shadow2418889/digital-typewriter/PCBs/3d models/dt-keyboard.step

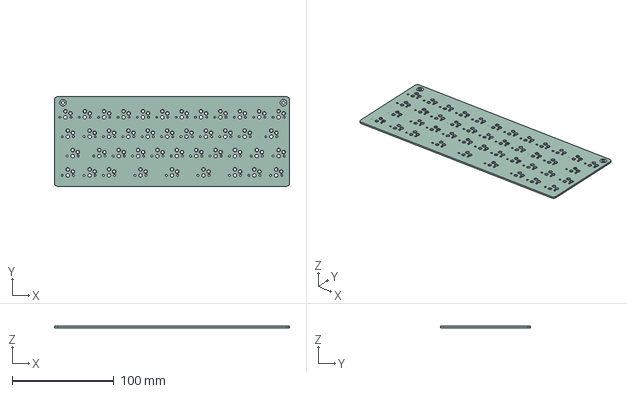
[picture p1: CAD file, 2025-12-10]
PCBs/3d models/dt-keyboard.step
231.0 x 88.1 x 1.59 mm
dt-keyboard_pad
dt-keyboard_PCB
