shadow2418889/digital-typewriter/journal assets/Part Studio 1(1).png

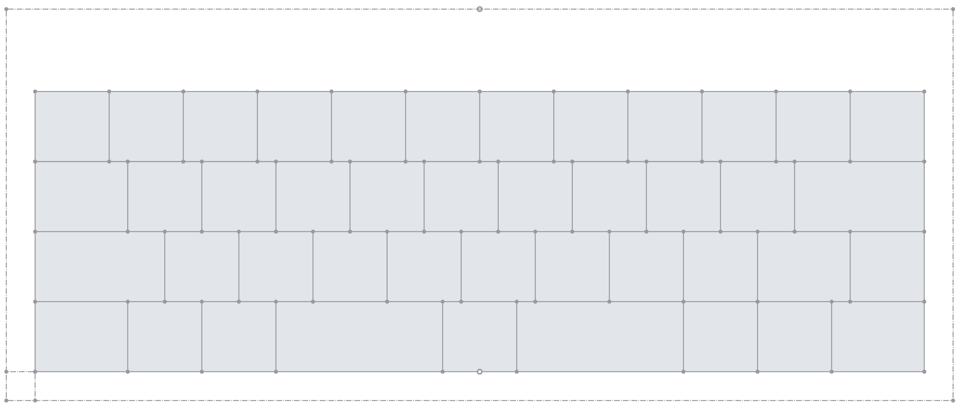
journal assets/Part Studio 1(1).png
