shadow2418889/digital-typewriter/PCBs/keyboard/dt-keyboard.kicad_pcb

## KiCad design PCBs/keyboard/dt-keyboard.kicad_pcb (2025-12-10)

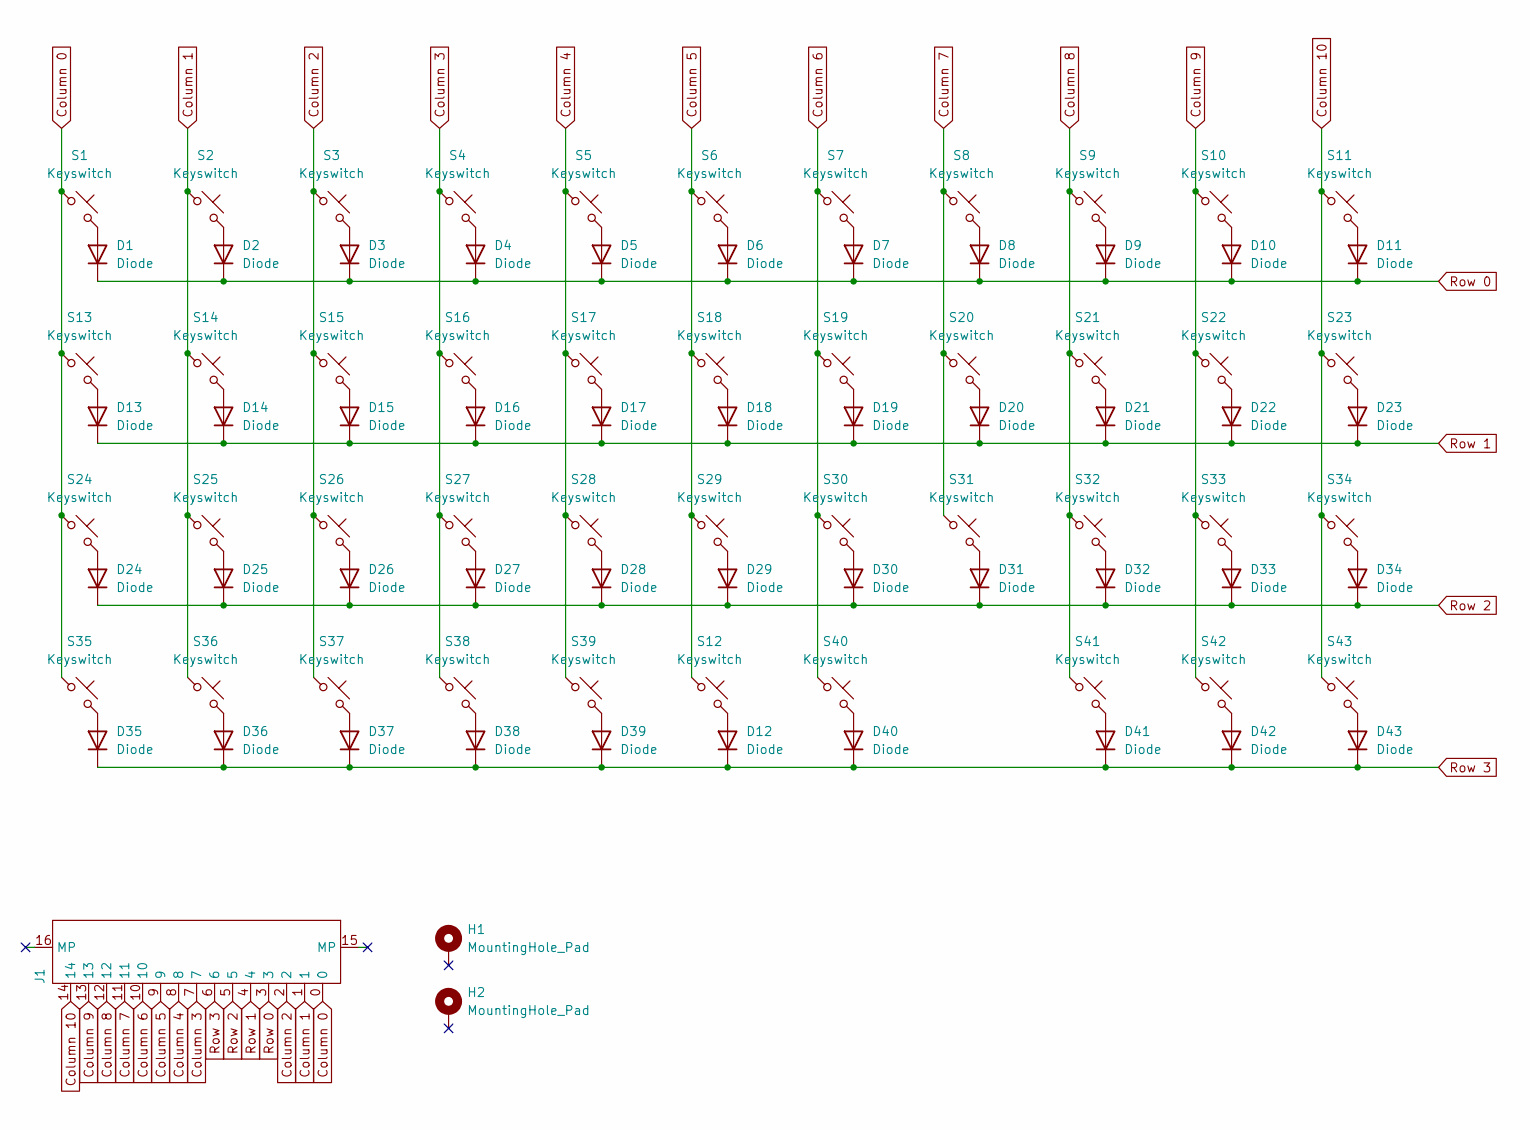
[picture p25: schematic dt-keyboard.kicad_sch]

Parts:
D1, D2, D3, D4, D5, D6, D7, D8, D9, D10, D11, D12, D13, D14, D15, D16, D17, D18, D19, D20, D21, D22, D23, D24, D25, D26, D27, D28, D29, D30, D31, D32, D33, D34, D35, D36, D37, D38, D39, D40, D41, D42, D43: Diode; Diode_SOD-123
H1, H2: MountingHole_Pad; MountingHole_3.2mm_M3_Pad_TopBottom
J1: FPC_15
S1, S2, S3, S4, S5, S6, S7, S8, S9, S10, S11, S12, S14, S15, S16, S17, S18, S19, S20, S21, S22, S25, S26, S27, S28, S29, S30, S31, S32, S34, S36, S37, S39, S41, S42: Keyswitch; MX Hotswap_Choc_V1_Plated_1.00u
S13, S33, S35, S43: Keyswitch; MX Hotswap_Choc_V1_Plated_1.25u
S23, S24: Keyswitch; MX Hotswap_Choc_V1_Plated_1.75u
S38, S40: Keyswitch; MX Hotswap_Choc_V1_Plated_2.25u

Connections:
Column 0: J1.0, S1.1, S13.1, S24.1, S35.1
Column 1: J1.1, S2.1, S14.1, S25.1, S36.1
Column 2: J1.2, S3.1, S15.1, S26.1, S37.1
Column 3: J1.7, S4.1, S16.1, S27.1, S38.1
Column 4: J1.8, S5.1, S17.1, S28.1, S39.1
Column 5: J1.9, S6.1, S12.1, S18.1, S29.1
Column 6: J1.10, S7.1, S19.1, S30.1, S40.1
Column 7: J1.11, S8.1, S20.1, S31.1
Column 8: J1.12, S9.1, S21.1, S32.1, S41.1
Column 9: J1.13, S10.1, S22.1, S33.1, S42.1
Column 10: J1.14, S11.1, S23.1, S34.1, S43.1
unnamed: D1.2 (A), S1.2
unnamed: D2.2 (A), S2.2
unnamed: D3.2 (A), S3.2
unnamed: D4.2 (A), S4.2
unnamed: D5.2 (A), S5.2
unnamed: D6.2 (A), S6.2
unnamed: D7.2 (A), S7.2
unnamed: D8.2 (A), S8.2
unnamed: D9.2 (A), S9.2
unnamed: D10.2 (A), S10.2
unnamed: D11.2 (A), S11.2
unnamed: D12.2 (A), S12.2
unnamed: D13.2 (A), S13.2
unnamed: D14.2 (A), S14.2
unnamed: D15.2 (A), S15.2
unnamed: D16.2 (A), S16.2
unnamed: D17.2 (A), S17.2
unnamed: D18.2 (A), S18.2
unnamed: D19.2 (A), S19.2
unnamed: D20.2 (A), S20.2
unnamed: D21.2 (A), S21.2
unnamed: D22.2 (A), S22.2
unnamed: D23.2 (A), S23.2
unnamed: D24.2 (A), S24.2
unnamed: D25.2 (A), S25.2
unnamed: D26.2 (A), S26.2
unnamed: D27.2 (A), S27.2
unnamed: D28.2 (A), S28.2
unnamed: D29.2 (A), S29.2
unnamed: D30.2 (A), S30.2
unnamed: D31.2 (A), S31.2
unnamed: D32.2 (A), S32.2
unnamed: D33.2 (A), S33.2
unnamed: D34.2 (A), S34.2
unnamed: D35.2 (A), S35.2
unnamed: D36.2 (A), S36.2
unnamed: D37.2 (A), S37.2
unnamed: D38.2 (A), S38.2
unnamed: D39.2 (A), S39.2
unnamed: D40.2 (A), S40.2
unnamed: D41.2 (A), S41.2
unnamed: D42.2 (A), S42.2
unnamed: D43.2 (A), S43.2
Row 0: D1.1 (K), D2.1 (K), D3.1 (K), D4.1 (K), D5.1 (K), D6.1 (K), D7.1 (K), D8.1 (K), D9.1 (K), D10.1 (K), D11.1 (K), J1.3
Row 1: D13.1 (K), D14.1 (K), D15.1 (K), D16.1 (K), D17.1 (K), D18.1 (K), D19.1 (K), D20.1 (K), D21.1 (K), D22.1 (K), D23.1 (K), J1.4
Row 2: D24.1 (K), D25.1 (K), D26.1 (K), D27.1 (K), D28.1 (K), D29.1 (K), D30.1 (K), D31.1 (K), D32.1 (K), D33.1 (K), D34.1 (K), J1.5
Row 3: D12.1 (K), D35.1 (K), D36.1 (K), D37.1 (K), D38.1 (K), D39.1 (K), D40.1 (K), D41.1 (K), D42.1 (K), D43.1 (K), J1.6

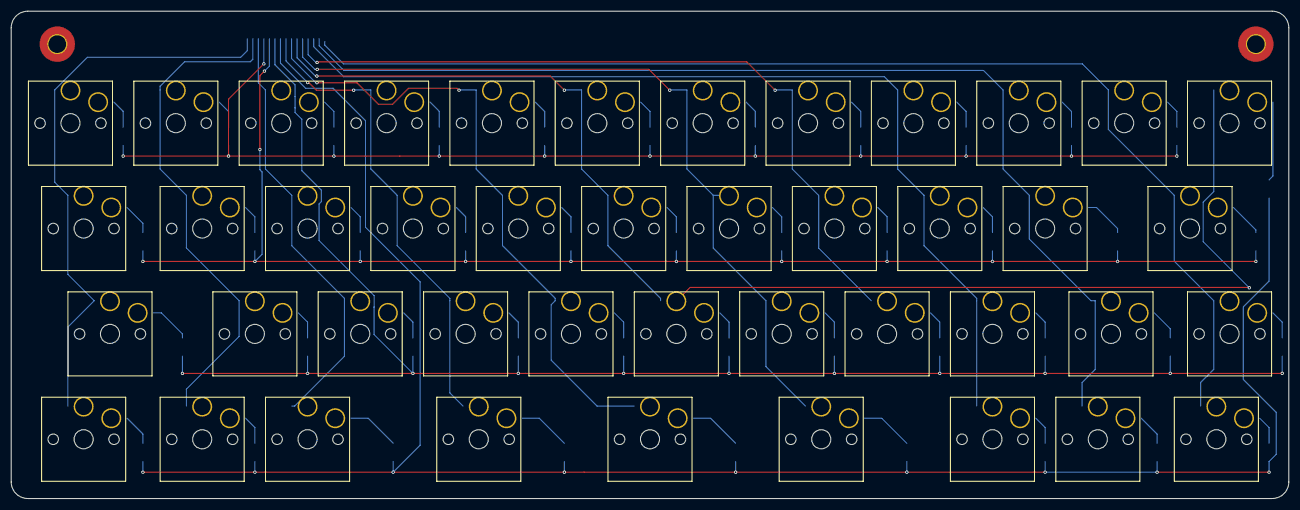
[picture p26: board dt-keyboard.kicad_pcb from above]

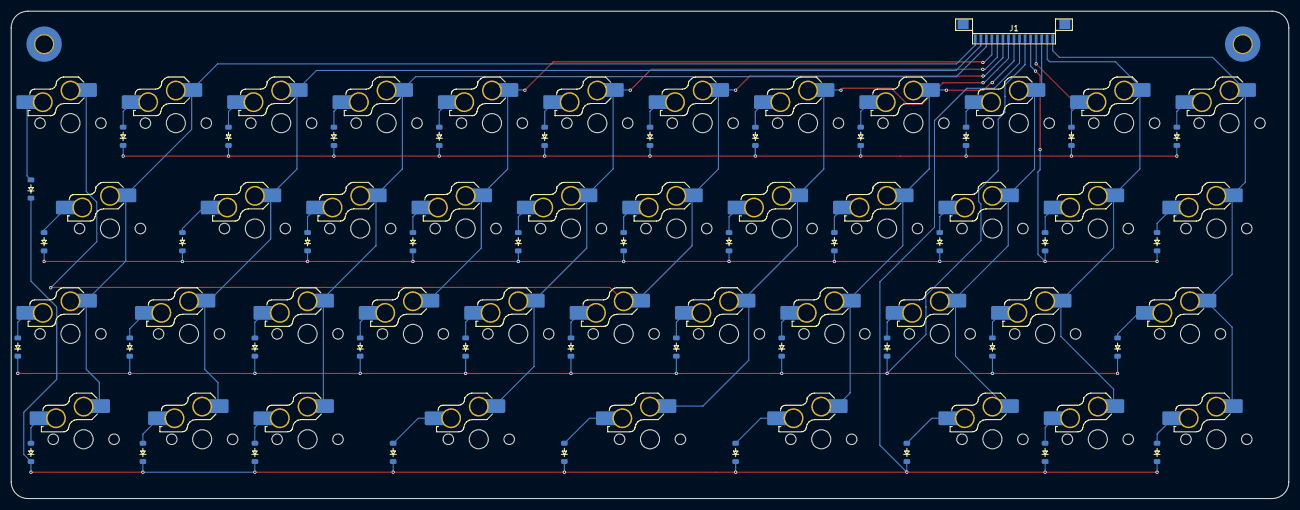
[picture p27: board dt-keyboard.kicad_pcb from below]

Board: 2 copper layers, 231.0 x 88.1 mm, 89 parts (44 on the bottom side), 58 nets.
