shadow2418889/digital-typewriter/PCBs/mainboard/mainboard.kicad_pcb

## KiCad design PCBs/mainboard/mainboard.kicad_pcb (2025-12-10)

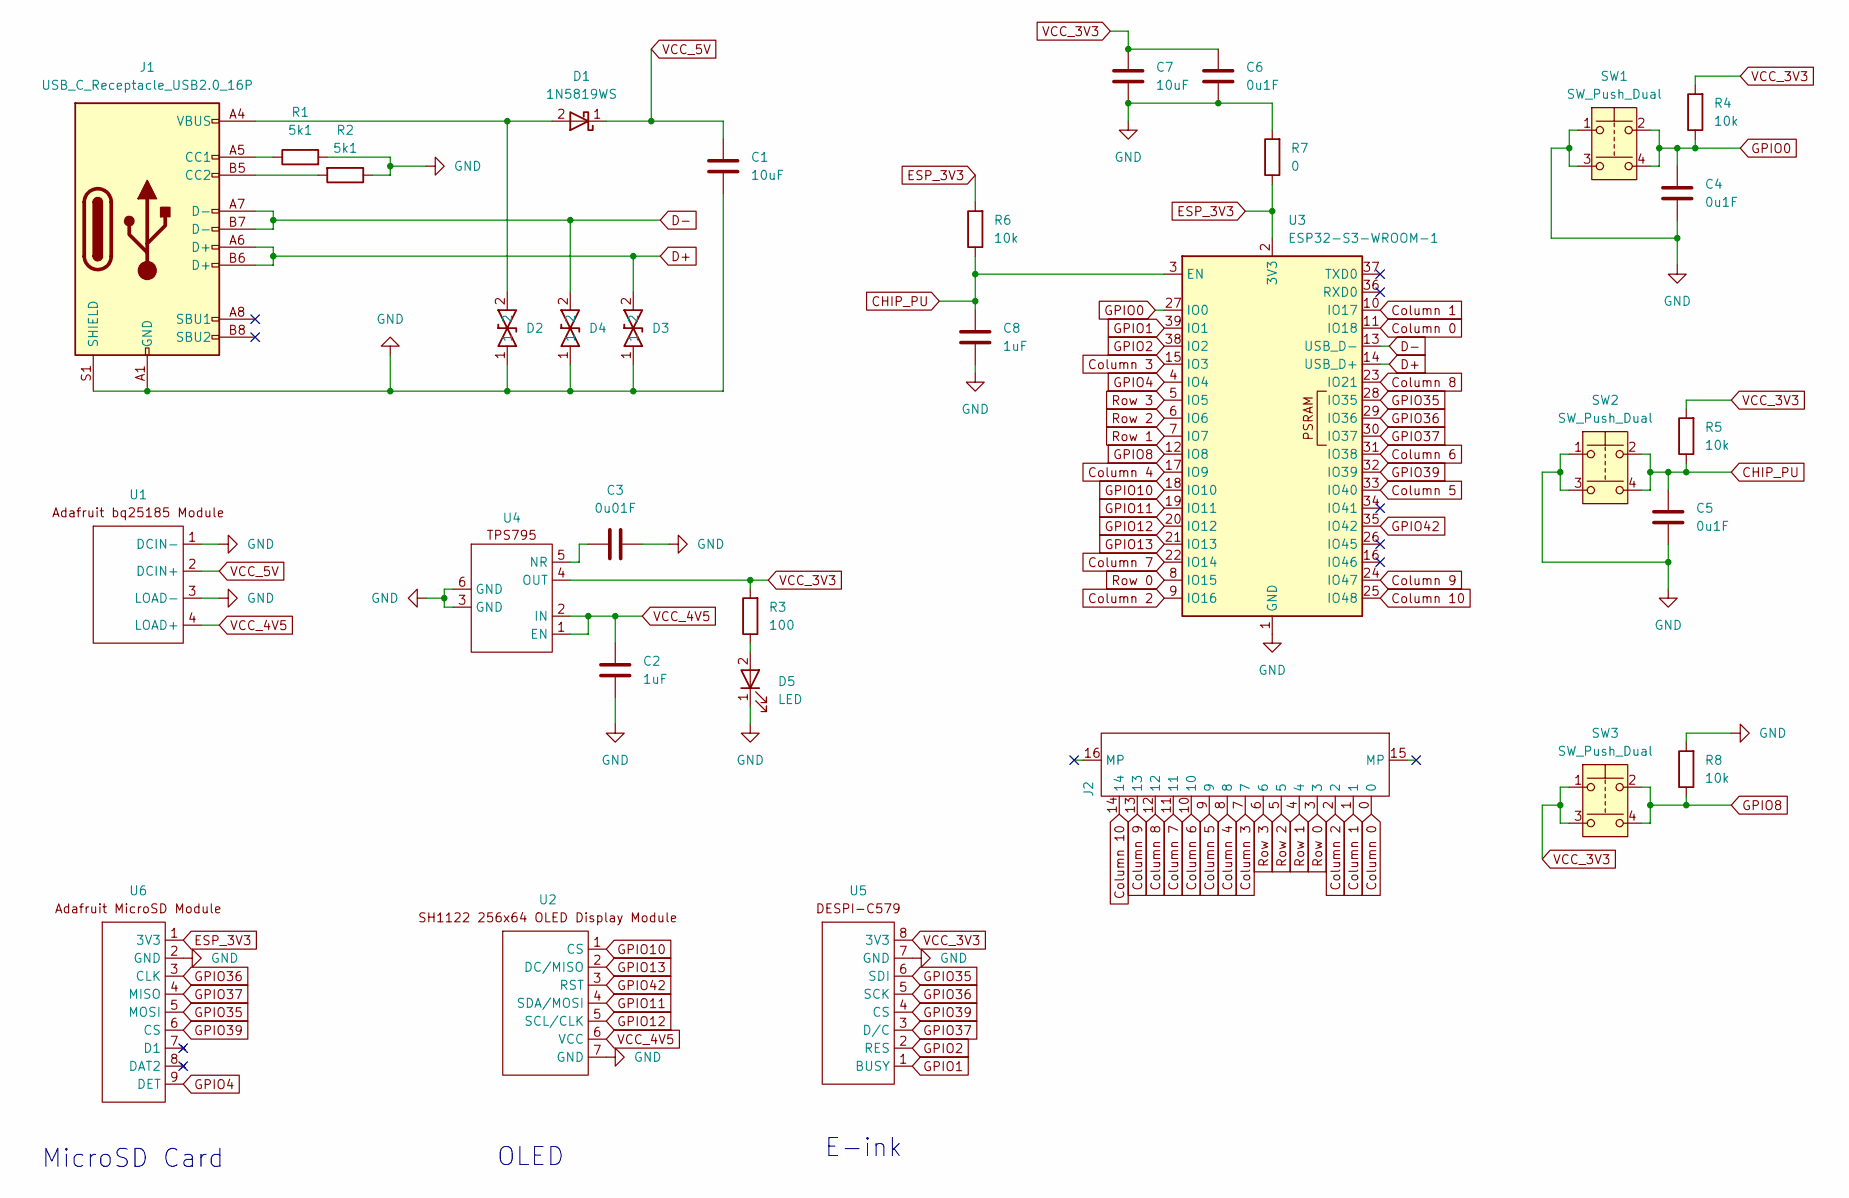
[picture p28: schematic mainboard.kicad_sch]

Parts:
C1, C7: 10uF; C_0805_2012Metric
C2, C8: 1uF; C_0805_2012Metric
C3: 0u01F; C_0805_2012Metric
C4, C5, C6: 0u1F; C_0805_2012Metric
D1: 1N5819WS; 1N5819HW-7-F
D2, D3, D4: LESD5D5
D5: LED; KT-0805G
J1: USB_C_Receptacle_USB2.0_16P; USB_C_Receptacle_16P
J2: FPC_15
R1, R2: 5k1; R_0805_2012Metric
R3: 100; R_0805_2012Metric
R4, R5, R6, R8: 10k; R_0805_2012Metric
R7: 0; R_0805_2012Metric
SW1, SW2, SW3: SW_Push_Dual; B3F-1000
U1: Adafruit bq25185 Module
U2: SH1122 256x64 OLED Display Module
U3: ESP32-S3-WROOM-1
U4: TPS795
U5: DESPI-C579
U6: Adafruit MicroSD Module

Connections:
CHIP_PU: C5.1, C8.1, R5.1, R6.1, SW2.2, SW2.4, U3.3 (EN)
Column 0: J2.0, U3.11 (IO18)
Column 1: J2.1, U3.10 (IO17)
Column 2: J2.2, U3.9 (IO16)
Column 3: J2.7, U3.15 (IO3)
Column 4: J2.8, U3.17 (IO9)
Column 5: J2.9, U3.33 (IO40)
Column 6: J2.10, U3.31 (IO38)
Column 7: J2.11, U3.22 (IO14)
Column 8: J2.12, U3.23 (IO21)
Column 9: J2.13, U3.24 (IO47)
Column 10: J2.14, U3.25 (IO48)
D+: D3.2, J1.A6 (D+), J1.B6 (D+), U3.14 (USB_D+)
D-: D4.2, J1.A7 (D-), J1.B7 (D-), U3.13 (USB_D-)
ESP_3V3: R6.2, R7.1, U3.2 (3V3), U6.1 (3V3)
GND: C1.2, C2.2, C3.1, C4.2, C5.2, C6.2, C7.2, C8.2, D2.1, D3.1, D4.1, D5.1 (K), J1.A1 (GND), J1.A12 (GND), J1.B1 (GND), J1.B12 (GND), J1.S1 (SHIELD), R1.2, R2.1, R7.2, R8.2, SW1.1, SW1.3, SW2.1, SW2.3, U1.1 (DCIN-), U1.3 (LOAD-), U2.7 (GND), U3.1 (GND), U3.40 (GND), U3.41 (GND), U4.3 (GND), U4.6 (GND), U5.7 (GND), U6.2 (GND)
GPIO0: C4.1, R4.1, SW1.2, SW1.4, U3.27 (IO0)
GPIO1: U3.39 (IO1), U5.1 (BUSY)
GPIO2: U3.38 (IO2), U5.2 (RES)
GPIO4: U3.4 (IO4), U6.9 (DET)
GPIO8: R8.1, SW3.2, SW3.4, U3.12 (IO8)
GPIO10: U2.1 (CS), U3.18 (IO10)
GPIO11: U2.4 (SDA/MOSI), U3.19 (IO11)
GPIO12: U2.5 (SCL/CLK), U3.20 (IO12)
GPIO13: U2.2 (DC/MISO), U3.21 (IO13)
GPIO35: U3.28 (IO35), U5.6 (SDI), U6.5 (MOSI)
GPIO36: U3.29 (IO36), U5.5 (SCK), U6.3 (CLK)
GPIO37: U3.30 (IO37), U5.3 (D/C), U6.4 (MISO)
GPIO39: U3.32 (IO39), U5.4 (CS), U6.6 (CS)
GPIO42: U2.3 (RST), U3.35 (IO42)
unnamed: D1.2 (A), D2.2, J1.A4 (VBUS), J1.A9 (VBUS), J1.B4 (VBUS), J1.B9 (VBUS)
unnamed: D5.2 (A), R3.1
unnamed: J1.A5 (CC1), R1.1
unnamed: J1.B5 (CC2), R2.2
unnamed: C3.2, U4.5 (NR)
Row 0: J2.3, U3.8 (IO15)
Row 1: J2.4, U3.7 (IO7)
Row 2: J2.5, U3.6 (IO6)
Row 3: J2.6, U3.5 (IO5)
VCC_3V3: C6.1, C7.1, R3.2, R4.2, R5.2, SW3.1, SW3.3, U4.4 (OUT), U5.8 (3V3)
VCC_4V5: C2.1, U1.4 (LOAD+), U2.6 (VCC), U4.1 (EN), U4.2 (IN)
VCC_5V: C1.1, D1.1 (K), U1.2 (DCIN+)

Notes on the sheet:
MicroSD Card
OLED
E-ink

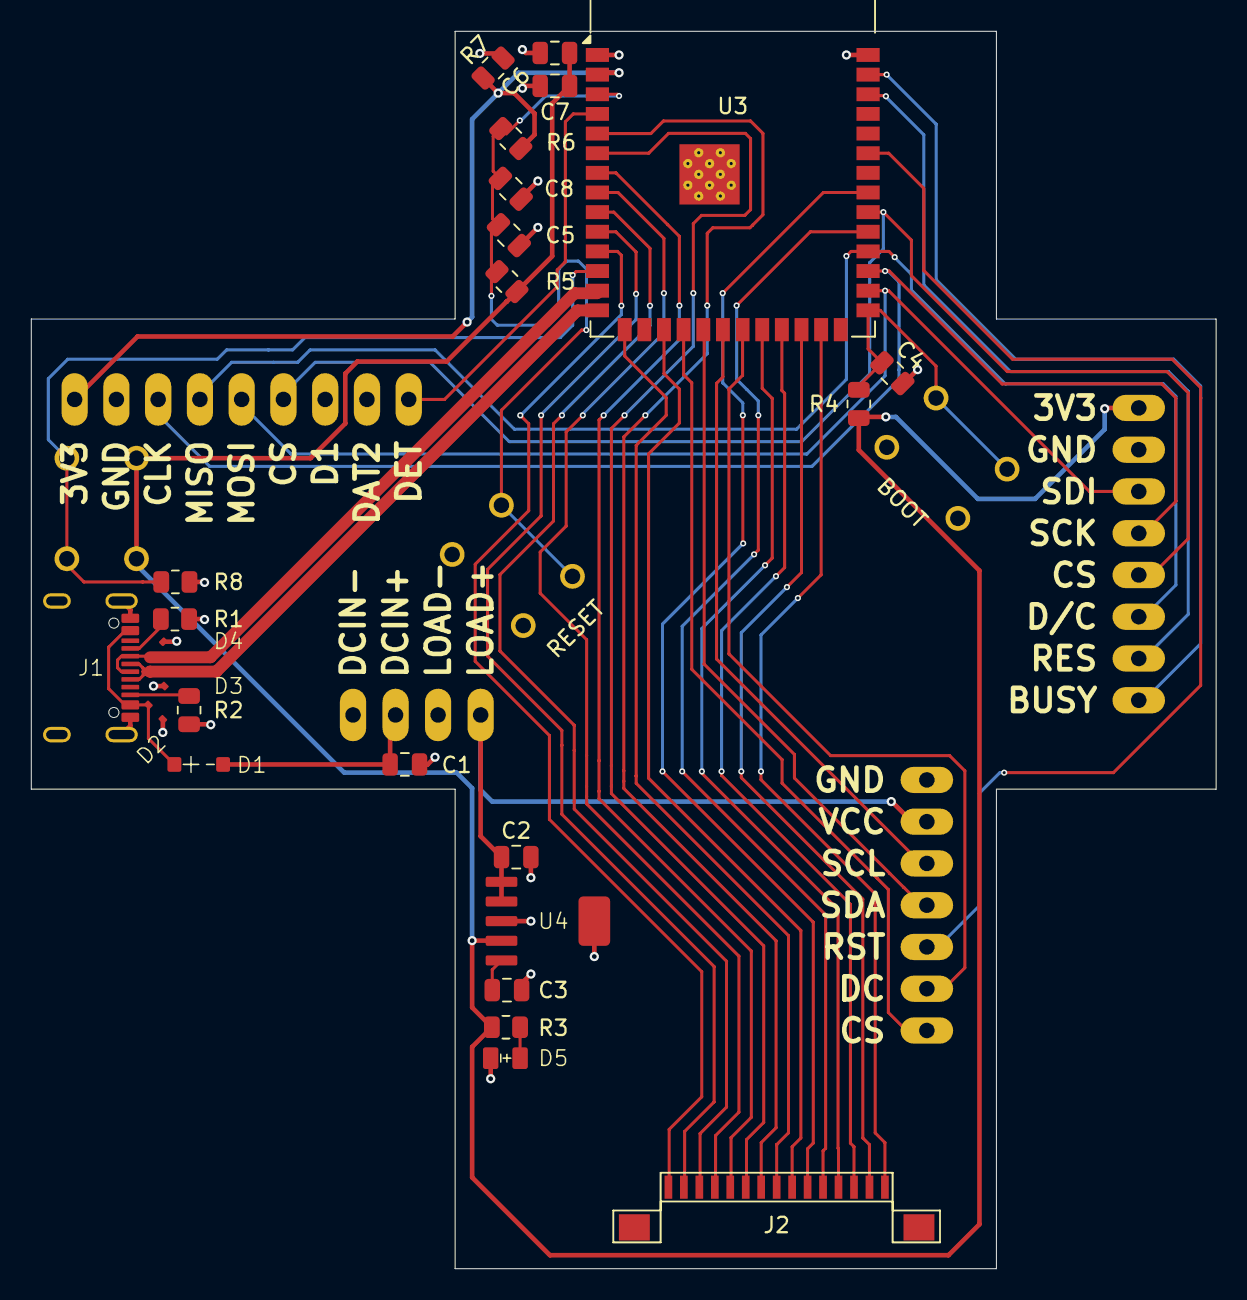
[picture p29: board mainboard.kicad_pcb from above]

Board: 4 copper layers, 76.6 x 80.0 mm, 32 parts (0 on the bottom side), 42 nets.
