shadow2418889/digital-typewriter/(commit log)

2025-07-16 Started work on PCB
    [digital typewriter pcb.kicad_pcb, digital typewriter pcb.kicad_sch, keyboard.kicad_sch]
2025-07-18 Finished Keyboard PCB
    [digital typewriter pcb.kicad_pcb, digital typewriter pcb.kicad_sch, dt-keyboard.kicad_pcb, dt-keyboard.kicad_sch, keyboard.kicad_sch]
2025-07-19 Fixed Keyboard
    [dt-keyboard.kicad_pcb, dt-keyboard.kicad_sch]
2025-07-20 Worked on power system
    [mainboard.kicad_pcb, mainboard.kicad_sch]
2025-07-21 Added ESP32 to Schematic
2025-07-23 Tested OLED
    [mainboard.kicad_sch]
2025-07-30 Fixed Display Code + Added Peripherals on Schematic
    [dt-keyboard.kicad_sch, mainboard.kicad_sch]
2025-07-30 CAD Mockup and Footprint Design
    [mainboard.kicad_sch]
2025-08-01 Layouting + Deep Sleep Tests
    [dt-keyboard.kicad_pcb, dt-keyboard.kicad_sch, mainboard.kicad_pcb, mainboard.kicad_sch]
2025-08-02 Layouting pt.1
    [mainboard.kicad_pcb]
2025-08-14 Routed peripherals
    [dt-keyboard.kicad_pcb, mainboard.kicad_pcb, mainboard.kicad_sch]
